GreyBeard-Engineering/CRAP/steps/gearbox/gearbox.step

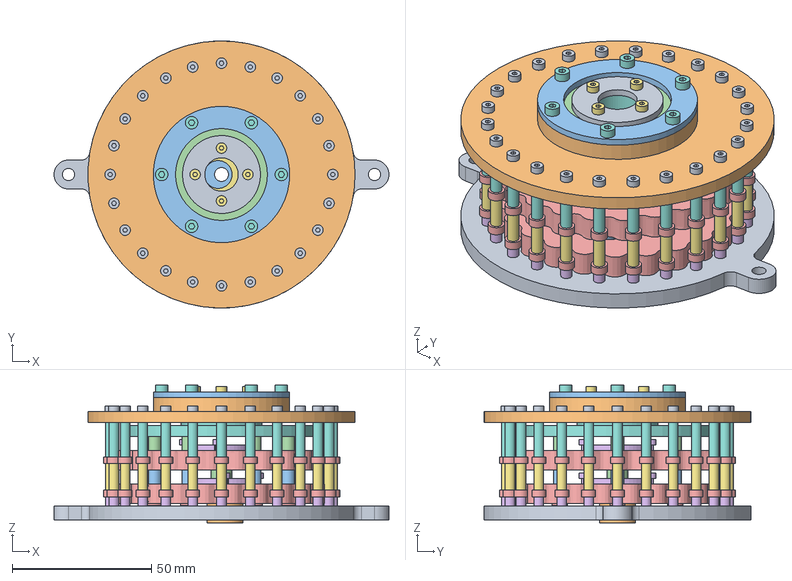
[picture p1: CAD file, 2026-10-11]
steps/gearbox/gearbox.step
120.4 x 96.0 x 49.5 mm
base
eccentric_insert
eccentric_insert_stacked
inter_eccentric_spacer
cycloid_2 x 2
cycloid_cap_2 x 2
input_bearing_2 x 2
output
output_cap
top
top_cap
output_bearing
roller_bearing_48 x 48
roller_spacer_bottom_24 x 24
inter_roller_spacer_24 x 24
roller_spacer_top_24 x 24
ring_bolt_M2x39_24 x 24
needle_roller_12 x 12
inter_needle_spacer_6 x 6
needle_spacer_6 x 6
needle_bolt_M3x25.8_6 x 6
cycloid_cap_bolt_M2x7_8 x 8
output_cap_bolt_M2x9_4 x 4
top_cap_bolt_M2.5x9_6 x 6
