GreyBeard-Engineering/CRAP/steps/test_cycloid.step

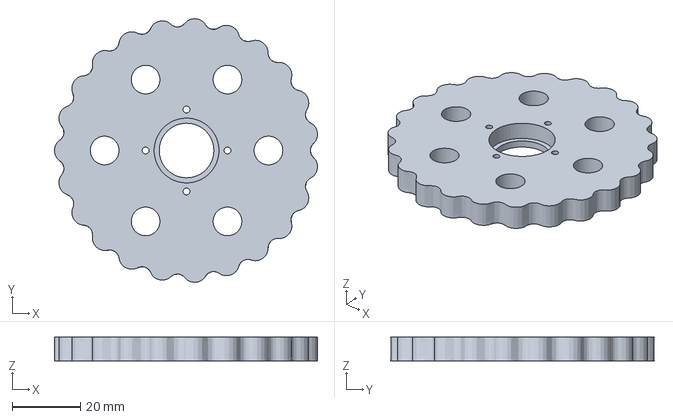
[picture p2: CAD file, 2026-10-11]
steps/test_cycloid.step
77.1 x 77.2 x 7.00 mm
