GreyBeard-Engineering/CRAP/steps/gearbox/roller_bearing.step

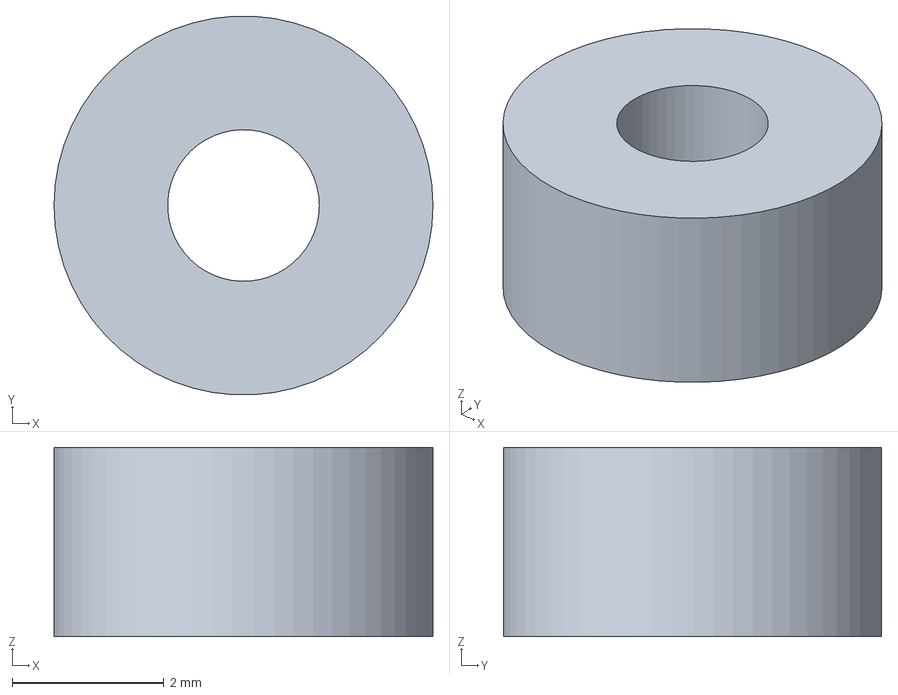
[picture p3: CAD file, 2026-10-11]
steps/gearbox/roller_bearing.step
5.00 x 4.99 x 2.50 mm
