GreyBeard-Engineering/CRAP/steps/test_cycloid_cap.step

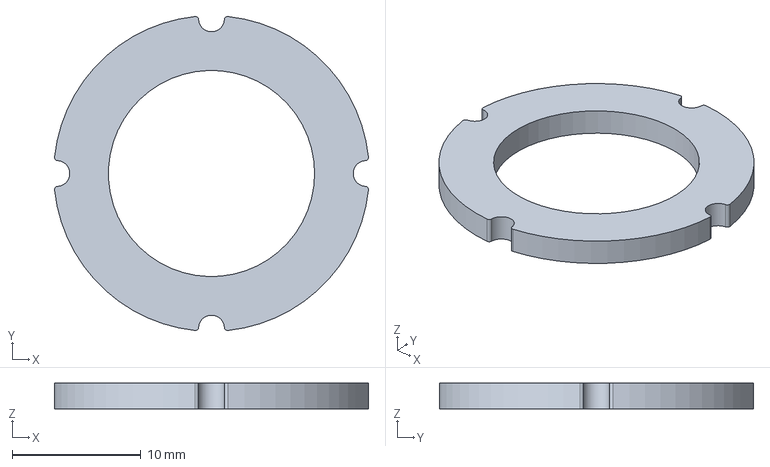
[picture p4: CAD file, 2026-10-11]
steps/test_cycloid_cap.step
24.4 x 24.4 x 2.00 mm
