GreyBeard-Engineering/CRAP/steps/output.step

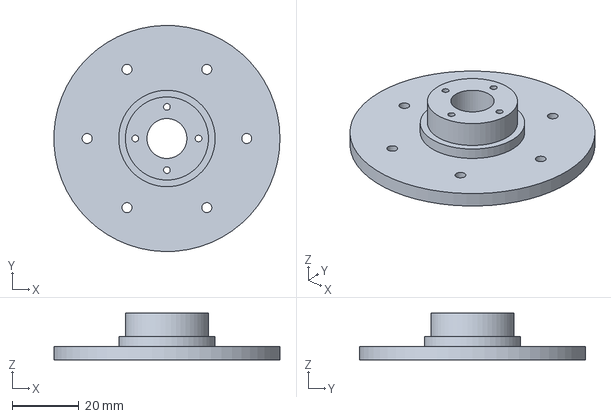
[picture p5: CAD file, 2026-10-11]
steps/output.step
68.0 x 68.0 x 14.0 mm
