GreyBeard-Engineering/CRAP/steps/eccentric_insert.step

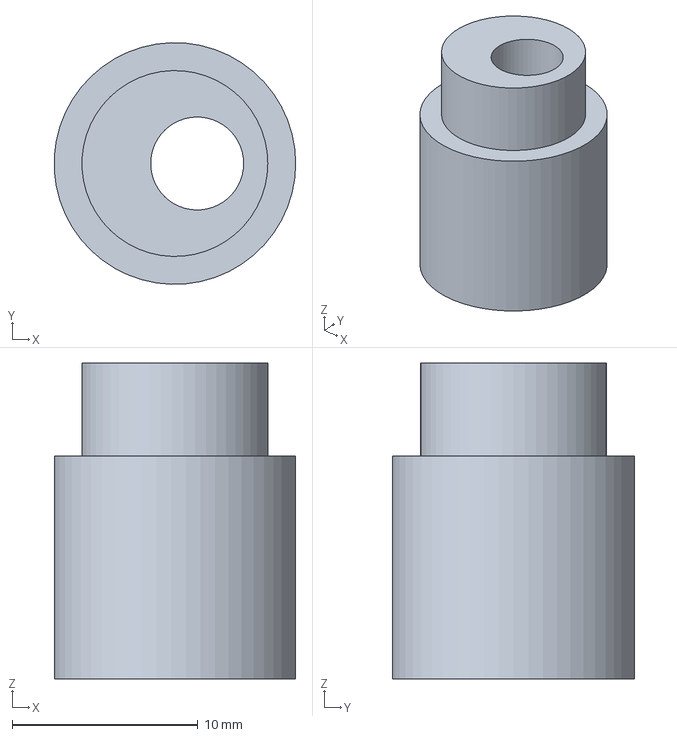
[picture p6: CAD file, 2026-10-11]
steps/eccentric_insert.step
13.0 x 13.0 x 17.0 mm
