GreyBeard-Engineering/CRAP/steps/gearbox/base.step

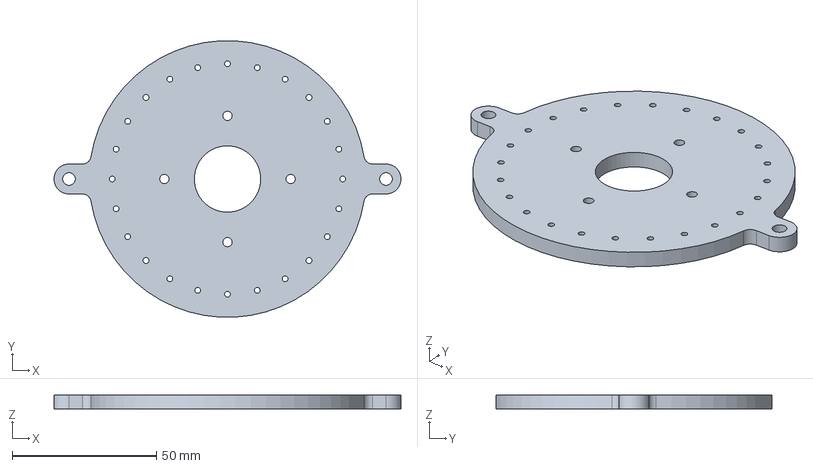
[picture p7: CAD file, 2026-10-11]
steps/gearbox/base.step
120.4 x 95.8 x 5.00 mm
