GreyBeard-Engineering/CRAP/steps/top.step

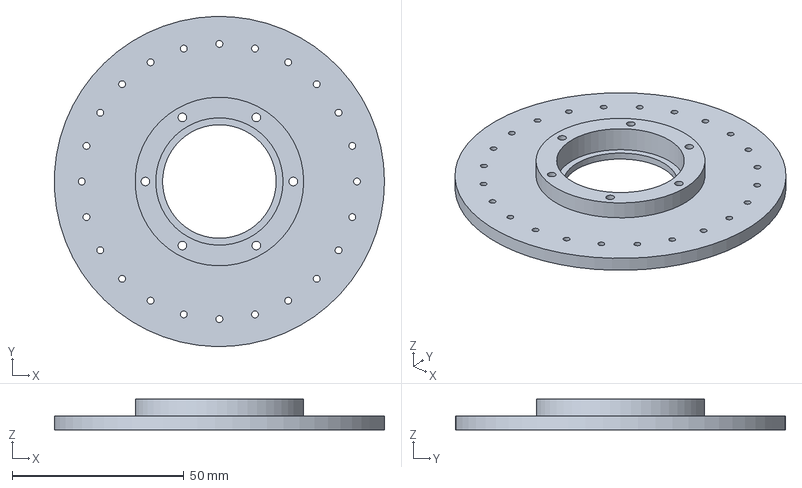
[picture p8: CAD file, 2026-10-11]
steps/top.step
95.9 x 96.0 x 9.00 mm
