GreyBeard-Engineering/CRAP/steps/gearbox/top_cap.step

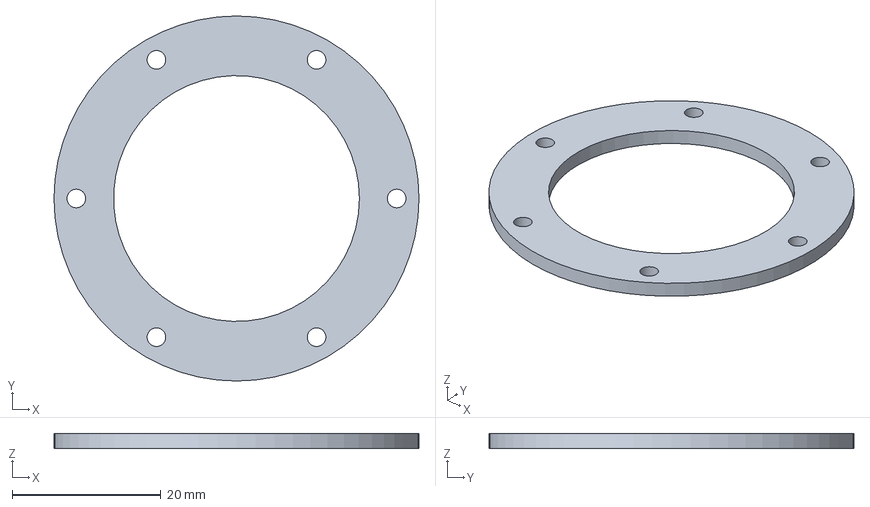
[picture p9: CAD file, 2026-10-11]
steps/gearbox/top_cap.step
49.0 x 49.0 x 2.00 mm
