GreyBeard-Engineering/CRAP/steps/output_cap.step

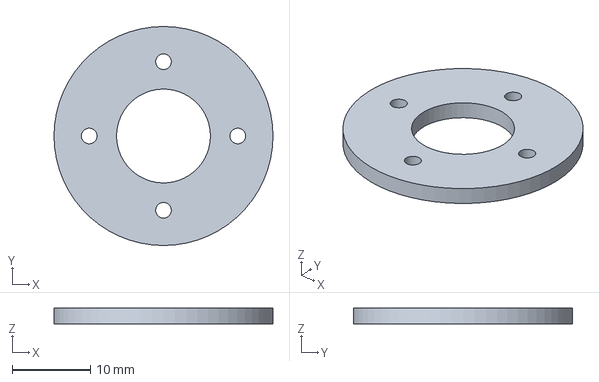
[picture p10: CAD file, 2026-10-11]
steps/output_cap.step
28.0 x 28.0 x 2.00 mm
