GreyBeard-Engineering/CRAP/steps/gearbox/needle_roller.step

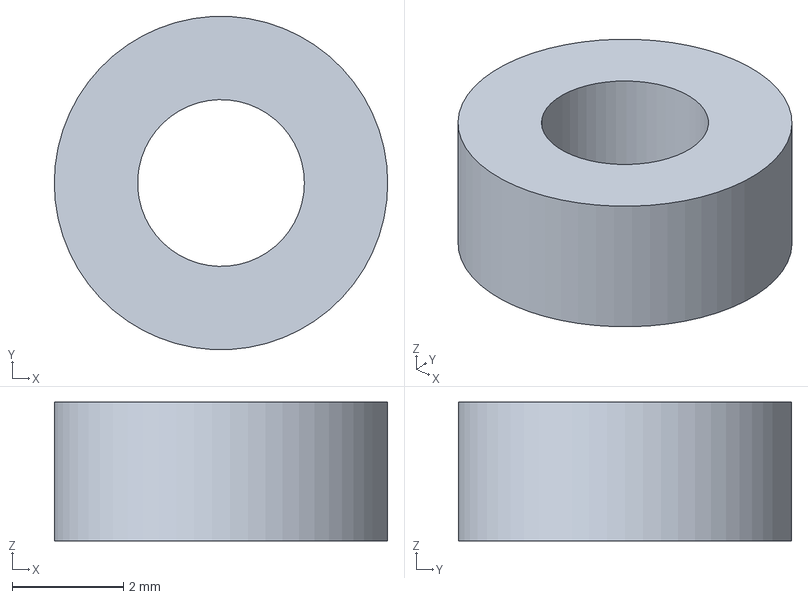
[picture p11: CAD file, 2026-10-11]
steps/gearbox/needle_roller.step
6.00 x 5.99 x 2.50 mm
