GreyBeard-Engineering/CRAP/steps/gearbox/output_bearing.step

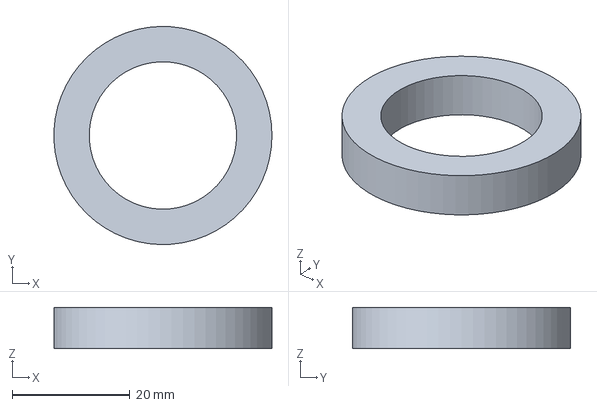
[picture p12: CAD file, 2026-10-11]
steps/gearbox/output_bearing.step
37.0 x 37.0 x 7.00 mm
