GreyBeard-Engineering/CRAP/steps/gearbox/needle_spacer.step

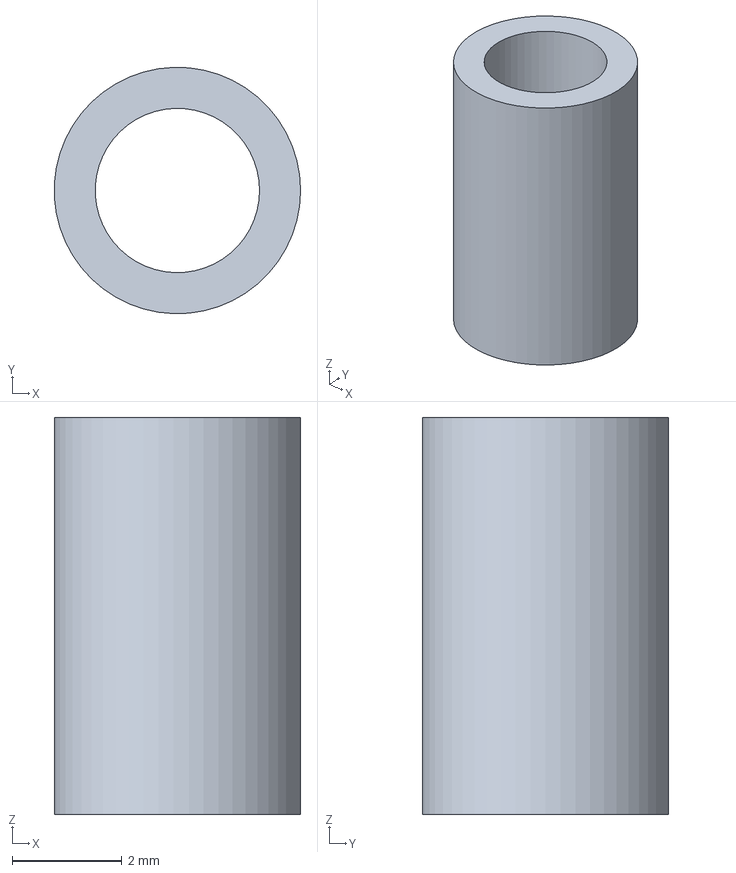
[picture p13: CAD file, 2026-10-11]
steps/gearbox/needle_spacer.step
4.50 x 4.50 x 7.25 mm
