GreyBeard-Engineering/CRAP/steps/gearbox/roller_spacer_bottom.step

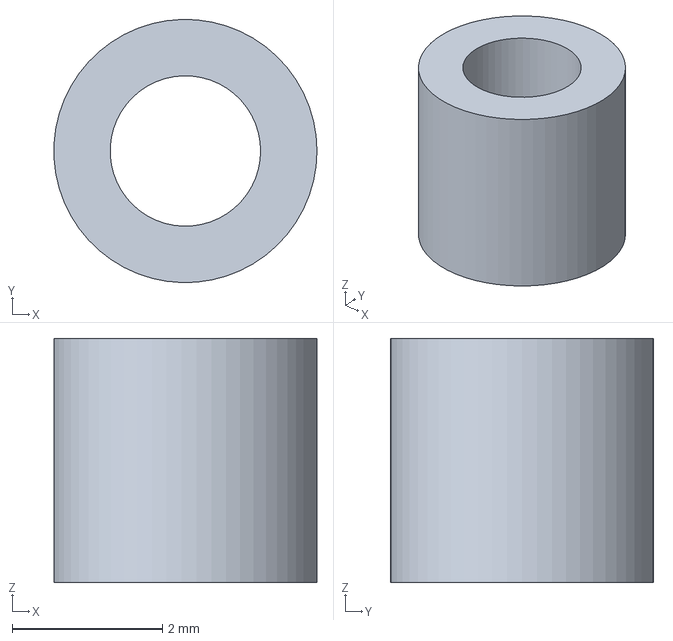
[picture p14: CAD file, 2026-10-11]
steps/gearbox/roller_spacer_bottom.step
3.50 x 3.50 x 3.25 mm
