GreyBeard-Engineering/CRAP/steps/gearbox/roller_spacer_top.step

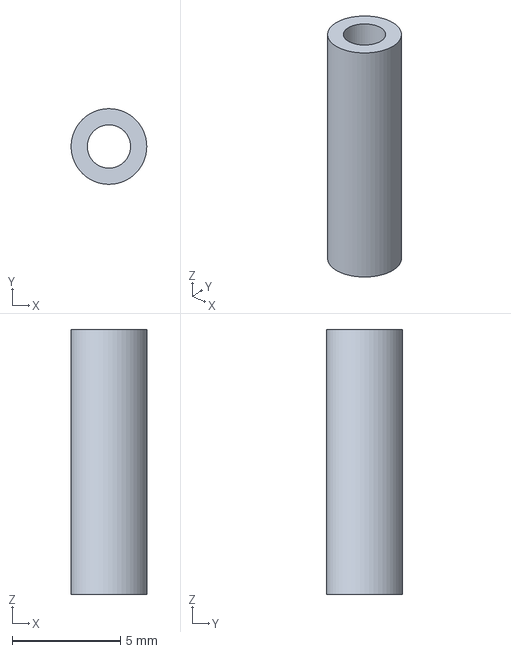
[picture p15: CAD file, 2026-10-11]
steps/gearbox/roller_spacer_top.step
3.50 x 3.50 x 12.2 mm
