GreyBeard-Engineering/CRAP/steps/gearbox/input_bearing.step

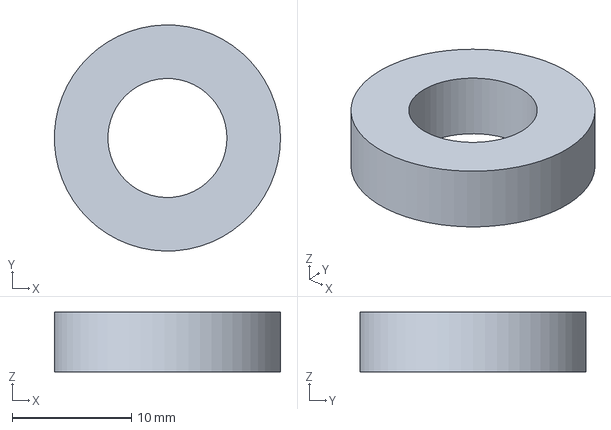
[picture p16: CAD file, 2026-10-11]
steps/gearbox/input_bearing.step
19.0 x 19.0 x 5.00 mm
