GreyBeard-Engineering/CRAP/steps/gearbox/eccentric_insert.step

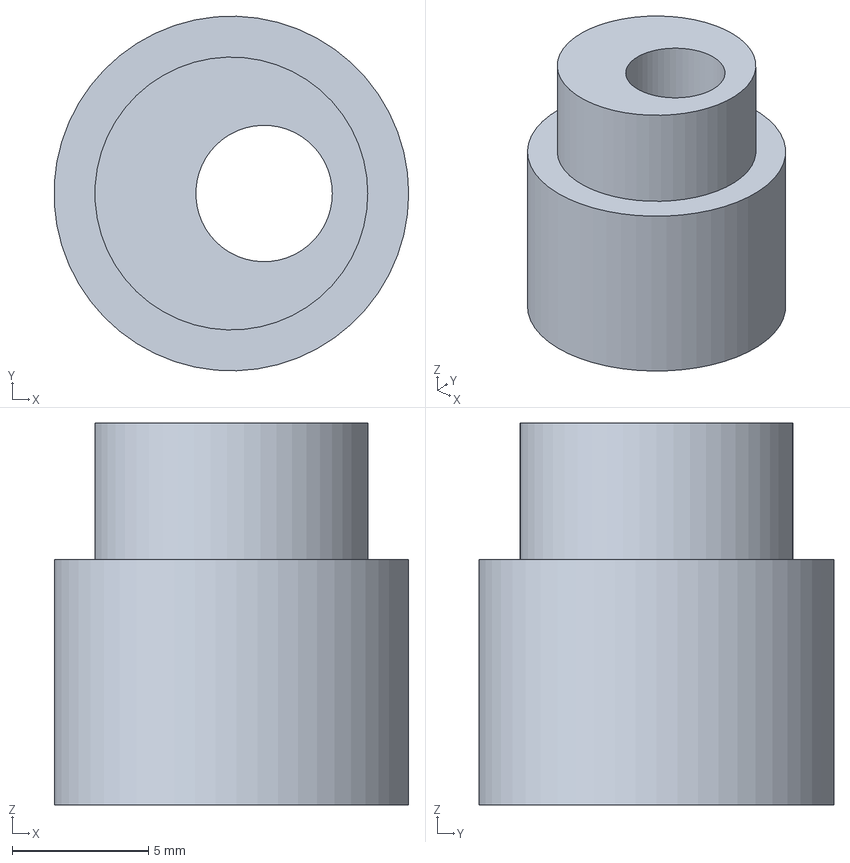
[picture p17: CAD file, 2026-10-11]
steps/gearbox/eccentric_insert.step
13.0 x 13.0 x 14.0 mm
