GreyBeard-Engineering/CRAP/(list of files, cad)

Other CAD files:
steps/cycloid.step
steps/gearbox/cycloid_cap.step
steps/gearbox/output.step
steps/cycloid_cap.step
steps/gearbox/output_cap.step
steps/top_cap.step
steps/base.step
steps/gearbox/top.step
steps/gearbox/cycloid.step
steps/gearbox/cycloid_cap_bolt_M2x7.step
steps/gearbox/needle_bolt_M3x13.8.step
steps/gearbox/output_cap_bolt_M2x9.step
steps/gearbox/ring_bolt_M2x25.step
steps/gearbox/ring_bolt_M2x27.step
steps/gearbox/top_cap_bolt_M2.5x9.step
