GreyBeard-Engineering/CRAP/(commit log)

2026-10-10 Add full cycloidal gearbox generator and assembly
    - New parts: eccentric insert, output (with bore) and inner-race output cap
    - Shared cap/flange dataclasses; caps can retain an inner or outer race
    - gearbox class: takes each dimension once, builds every part, and exports
    an assembly STEP with plate_spacing gaps between plates
    - hardware helpers: bored_cylinder, bearings, inner-race spacers, ISO 4762
    socket head bolts; ring rollers, output needles, main bearings and cap
    screws placed in the assembly
    - Cycloid uses output needle roller OD + e for output holes and a stepped
    bearing pocket with its own cap
    [base.step, cycloid.step, cycloid_cap.step, cycloid_cap_bolt_M2x7.step, eccentric_insert.step, gearbox.step, input_bearing.step, needle_pin.step]
2026-10-10 Add PCO web GUI with live preview, export tab and tolerancing
    - web/: FastAPI server + three.js viewer. Live rebuild from a Manual
    Configuration tab (ratio, eccentricity and plate spacing pinned; Bearings
    and per-part sub-tabs), animated input/cycloid/output motion, X/Y/Z/home
    views, section view through the axis, per-part visibility chips
    - Export tab: STEP or STL, every part or custom parts only, optional
    tolerancing with editable magnitudes and per-feature tight/loose fits;
    downloads a zip with export_settings.json
    - tolerancing.py: export-time fits for bolt holes, bearing seats/journals,
    spacer bores and cycloid clearance; the nominal model is untouched
    - gearbox: EXAMPLE_KWA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
    [base.step, cycloid.step, cycloid_cap.step, cycloid_cap_bolt_M2x7.step, eccentric_insert.step, gearbox.step, input_bearing.step, needle_pin.step]
2026-10-10 Move all STEP files into steps/
    - Root-level generator outputs now live in steps/, the full gearbox
    (parts + assembly) in steps/gearbox/ (was gearbox_out/)
    - Generators, gearbox.generate()/export_assembly() and test_cycloid.py
    default to these paths and create the folder if it is missing
    [base.step, cycloid.step, cycloid_cap.step, cycloid_cap_bolt_M2x7.step, eccentric_insert.step, gearbox.step, input_bearing.step, needle_pin.step]
2026-10-11 Rebrand to CRAP; add Simple mode solver, README and many refinements
    CRAP: Cycloidal Reducer Algorithm & Parametrizer
    - New name, tagline and cycloid-disc logo/favicon in the GUI
    - README with usage, design notes and credits
    Simple / Advanced configuration
    - Simple mode: bearings, motor, ratio, e and roller R in; solver.py
    derives every other dimension, iterates on coded geometry errors
    (errors.py) and finishes with an exact collision check
    (gearbox.collisions()); Advanced mode keeps every dimension editable
    - Motor tab with face mount (drives the base motor-hole export fit)
    - Cycloid undercut check (found by the solver sweep); test_solver.py
    Geometry and GUI refinements since the la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
    [base.step, cycloid.step, cycloid_cap.step, cycloid_cap_bolt_M2x7.step, eccentric_insert.step, gearbox.step, input_bearing.step, needle_bolt_M3x13.75.step]
2026-10-11 Hide plate spacing in Simple mode; make browsers revalidate static files
2026-10-11 Harden Simple mode from 10 edge-case build attempts
    Drove /api/build in Simple mode with edge designs (compact NEMA14,
    47:1, 5:1 with big rollers, big NEMA23, near-undercut e, imperial
    needle rollers, ...) and fixed what they exposed:
    - Insert wall: require a real wall (insert_wall=1.0) around the motor
    shaft offset by e, and say which input bearing ID would fit
    - Output-hole layout: drop a doubled wall between the cycloid cap edge
    and the holes; when holes don't fit, only step the cap screw if it is
    the limit and a smaller size exists, otherwise report the roller R
    needed (room grows 1:1 with roller R)
    - Cap screws also limited to half the bearing width (no M6 on a 2.5 mm
    cap for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
    [base.step, cycloid.step, cycloid_cap.step, cycloid_cap_bolt_M2x7.step, eccentric_insert.step, gearbox.step, input_bearing.step, needle_bolt_M3x13.8.step]
2026-10-11 Remove stale needle screw STEP (renamed to M3x13.8)
    [needle_bolt_M3x13.75.step]
2026-10-11 Compact layout, best-effort builds with collision display, revert button
    Ten compact-design build attempts with a small motor (Ø5 shaft, 2 mm
    holes on R12) drove these changes; the smallest clean design went from
    roller R 24 to R 17.4:
    - Compact layout: when the cycloid cap's screw ring would push the output
    holes out, the cap reaches over the holes (it gets the same holes cut)
    and its screws sit half a pitch between them (patterned_hole gains
    start_angle, honoured everywhere a pattern is cut or placed; caps take
    extra cutouts; the cycloid checks screw-vs-hole clearance instead of
    "cap covers the holes")
    - "At least" suggestions round up, and fit checks tolerate float noise,
    so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
    [base.step, cycloid.step, cycloid_cap.step, cycloid_cap_bolt_M2x7.step, eccentric_insert.step, gearbox.step, input_bearing.step, needle_bolt_M3x13.8.step]
2026-10-11 Output holes outward; cycloid cap outline set by the output holes
    - Simple mode puts the output holes as far out as the walls allow
    (largest moment arm, lowest pin forces) instead of mid-band; the output
    plate stays sized to clear the rollers
    - One layout instead of standard/compact: the cycloid cap's outer radius
    is the output-hole circle + 1/4 hole radius, so every hole notches its
    edge, with 1/4-hole-radius fillets on the notch corners; its screws sit
    half a pitch between the holes. This is the generator's rule (both
    modes): cycloid_cap() / make_cycloid_cap(); the cap's edge_offset field
    is derived for the cycloid cap
    - make_cap() can fillet where cutouts meet its outer edge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
    [base.step, cycloid.step, cycloid_cap.step, cycloid_cap_bolt_M2x7.step, eccentric_insert.step, gearbox.step, input_bearing.step, needle_bolt_M3x13.8.step]
2026-10-11 Collision-only validity, config save/load, cycloid cap notched by its screws
    - A design is good to go when nothing collides (and every part builds):
    layout-rule problems stay in the server log; the GUI no longer shows
    them, and export only refuses colliding or unbuildable designs.
    Lenient gearboxes export leniently too.
    - Export tab: save every parameter, the mode, tolerances and export
    choices to a JSON file, and load one back (missing keys keep defaults)
    - Cycloid cap outline (generator rule, both modes): outer radius = its
    screw circle + 1/4 screw-hole radius, so the screws notch the edge,
    with 1/4-screw-radius fillets on the notch corners; it only gets the
    output holes cut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
    [base.step, cycloid.step, cycloid_cap.step, cycloid_cap_bolt_M2x7.step, eccentric_insert.step, gearbox.step, input_bearing.step, needle_bolt_M3x13.8.step]
2026-10-11 done I think
    [gearbox.step, test_cycloid.step, test_cycloid_cap.step]
2026-10-11 Fast clearance check: cylinder envelopes swept over a full input turn
    Every part gets an envelope next to its generator (Z-aligned cylinders and
    rings, holes as voids; the cycloid as its outline). Cylinder pairs are tested
    exactly; the cycloid's outer and inner outlines are tested as points against
    the other parts' cylinders. Each rigid body is posed like the GUI animation at
    360 input angles. ~0.2 s per design vs 5-8 s for the exact check at one pose.
    - gearbox.collisions(mode="fast"|"exact"), hits as (a, b, depth_mm, theta_deg)
    - drop the _overlap centroid filter (it hid real ring-shaped overlaps)
    - Advanced builds and exports run the check too
    - GUI lists depth and angle; clicking a pair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
